HexabitzPlatform/H09R9x-Hardware/README.md

# H09R9x-Hardware
Hexabitz Thermopile Sensor Module Hardware Design
