HexabitzPlatform/H09R9x-Hardware/Rleased/BOM/H09R9.xlsx

 |  | www.hexabitz.com info@hexabitz.com |  | Bill Of Materials
Customer | Hexabitz | Revision | 1
Project | Hexabitz Modules | Date | 2024-02-12
Board | Thermopile Sensor Module (H09R9) | Notes
Designator | Description | Manufacturer Part Number | Manufacturer | Octopart Url | Quantity
R | Headers & Wire Housings Unshrouded 1 POS T/H | 5-146280-1 | TE Connectivity | https://octopart.com/5-146280-1-te+connectivity+%2F+amp-40259676?r=sp | 1
SWD | Conn Unshrouded Header HDR 3 POS 2.54mm Solder ST Top Entry Thru-Hole Carton | 5-146281-3 | TE Connectivity | https://octopart.com/5-146281-3-te+connectivity+%2F+amp-39745942?r=sp | 1
R3 | RES SMD 0.0OHM JUMPER 1/10W 0603 | RC0603JR-070RL | YAGEO [VR] | https://octopart.com/rc0603jr-070rl-yageo-1241539?r=sp | 1
R1 | Thick Film Resistors - SMD 0603 270 Ohm 5% Tol | ERJ-3GEYJ271V | Panasonic | https://octopart.com/erj-3geyj271v-panasonic-55560546?r=sp | 1
R2, R4, R5 | RES 10K Ohm 1% 0603 | RC0603FR-0710KL | Yageo | https://octopart.com/rc0603fr-0710kl-yageo-40025538?r=sp | 3
C1, C6, C7, C8, C10 | CAP CER 0.1UF 25V X7R 0603 | CGA3E2X8R1E104K080AE | TDK | https://octopart.com/cga3e2x8r1e104k080ae-tdk-68305753?r=sp (https://octopart.com/c0603c104k8ractu-kemet-145075?r=sp) | 5
C2 | CAP CER 1 UF 16V X7R 0805 | CC0805KKX7R7BB105 | YAGEO [VA] | https://octopart.com/cc0805kkx7r7bb105-yageo-8376555?r=sp | 1
C3, C4, C11 | CAP CER 4.7UF 16V X7R 0805 | C0805C475K4RACTU | KEMET [VA] | https://octopart.com/c0805c475k4ractu-kemet-22859922?r=sp (https://octopart.com/10tpu4r7msi-panasonic-29487748?r=sp) | 3
FB1 | Ind chip Bead Multi-Layer 30 ohms 25% 100MHZ Ferrite 1,5A 0603Punched paper T/R | MMZ1608Y300BTA00 | TDK | https://octopart.com/mmz1608y300bta00-tdk-7906990?r=sp | 1
D1 | Red 0603 130° Clear 54 mcd 2 V Surface Mount ChipLED | VLMS1300-GS08 | Vishay | https://octopart.com/vlms1300-gs08-vishay-21709201?r=sp | 1
U1 | MCU 32-Bit ARM Cortex-M0+ RISC 512kByte Flash 1.7V to 3.6V 48-Pin UFQFPN Tray | STM32G0B1CEU6N | STMicroelectronics | https://octopart.com/stm32g0b1ceu6n-stmicroelectronics-116364672?r=sp | 1
U2 | TSD305 Series 1.68 to 3.6 V 100 uA Through Hole Digital Temperature Sensor -TO-5 | TSD305-1C55 | TE Connectivity | https://octopart.com/g-tpmo-101-te+connectivity-76900424?r=sp | 1
X1 | 8,0000MHZ 33pF SMD MURATA Resonators | CSTNE8M00G550000R0 | Murata | https://octopart.com/cstne8m00g550000r0-murata-91406934?r=sp | 1
