HexabitzPlatform/H09R9x-Hardware/Documentation/H09R9 Schematics.pdf

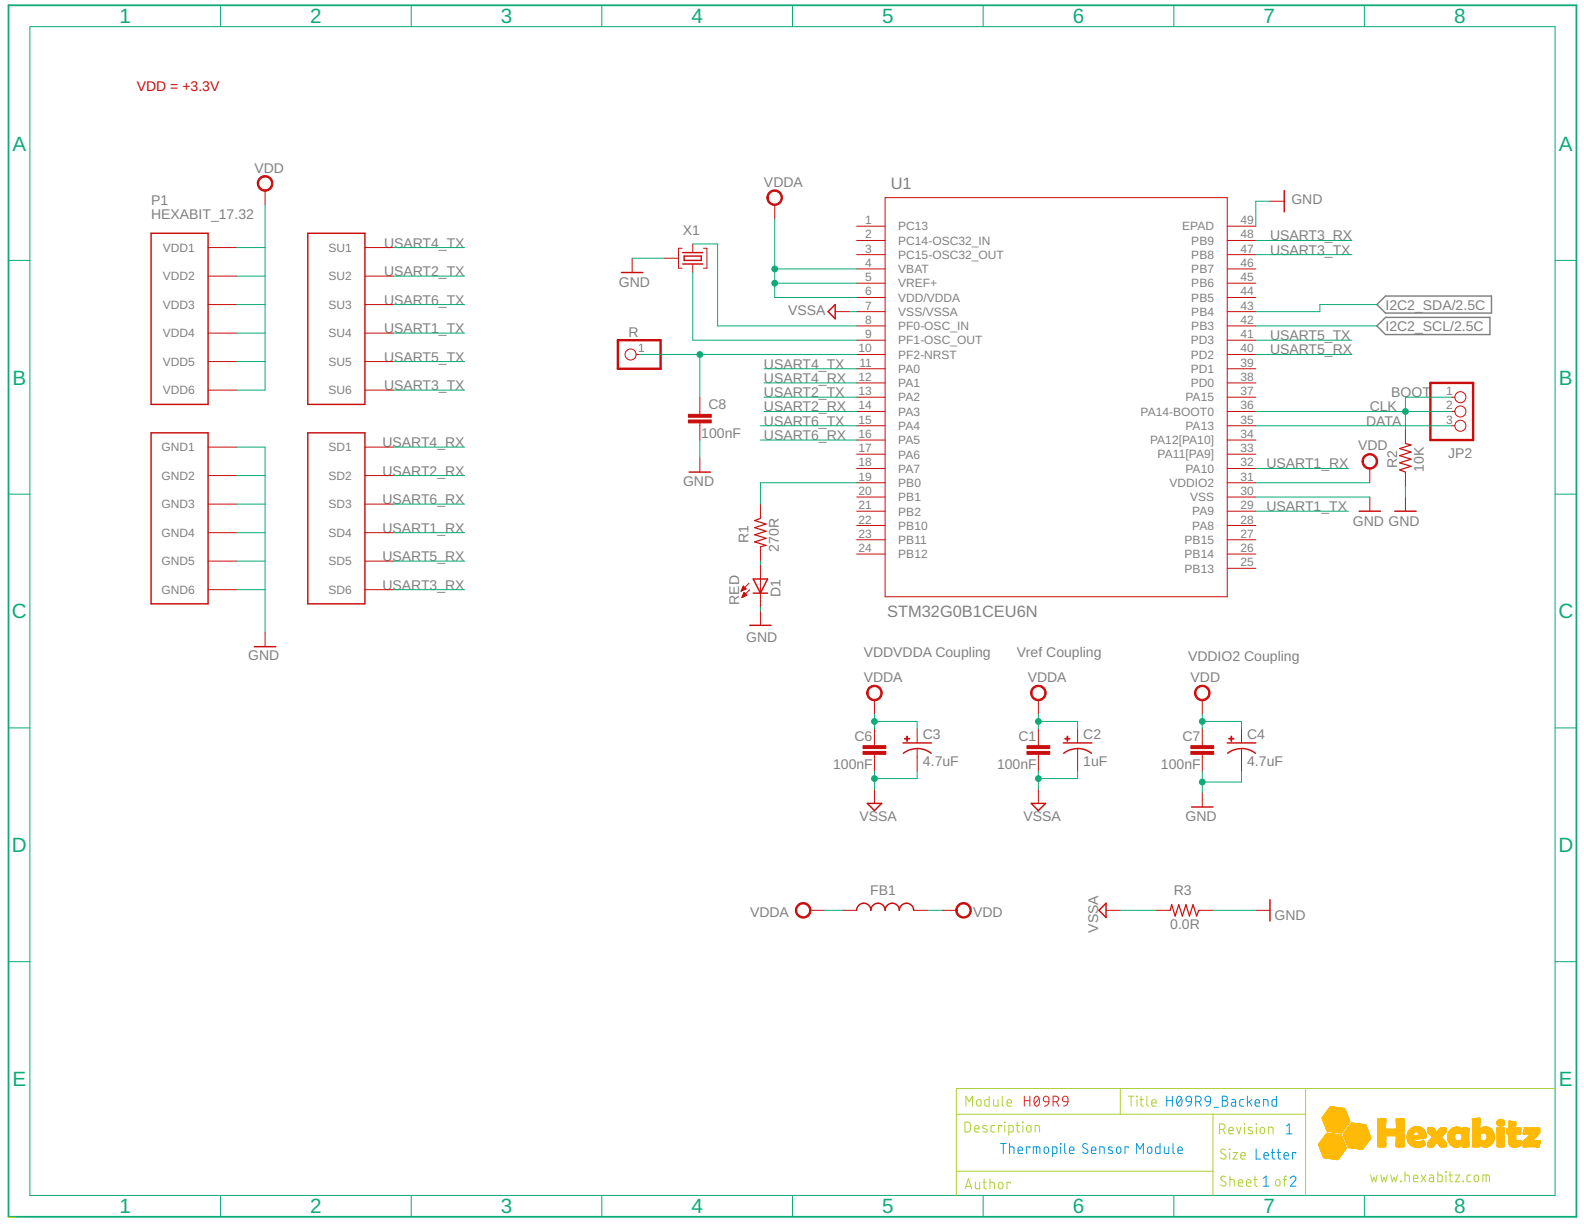
[picture p1: page 1]

5 | 45 PB7
6 | 44 PB6

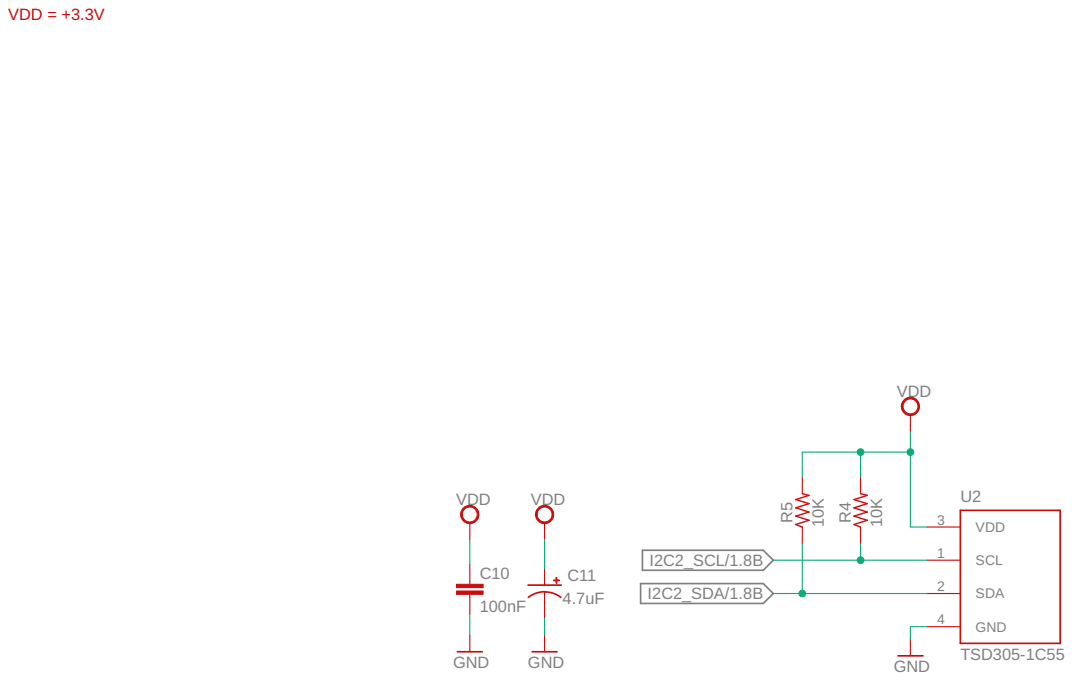
[picture p2: page 2]
