HexabitzPlatform/H09R9x-Hardware/Design/H09R9.brd

## EAGLE design Design/H09R9.brd (2024-02-13)

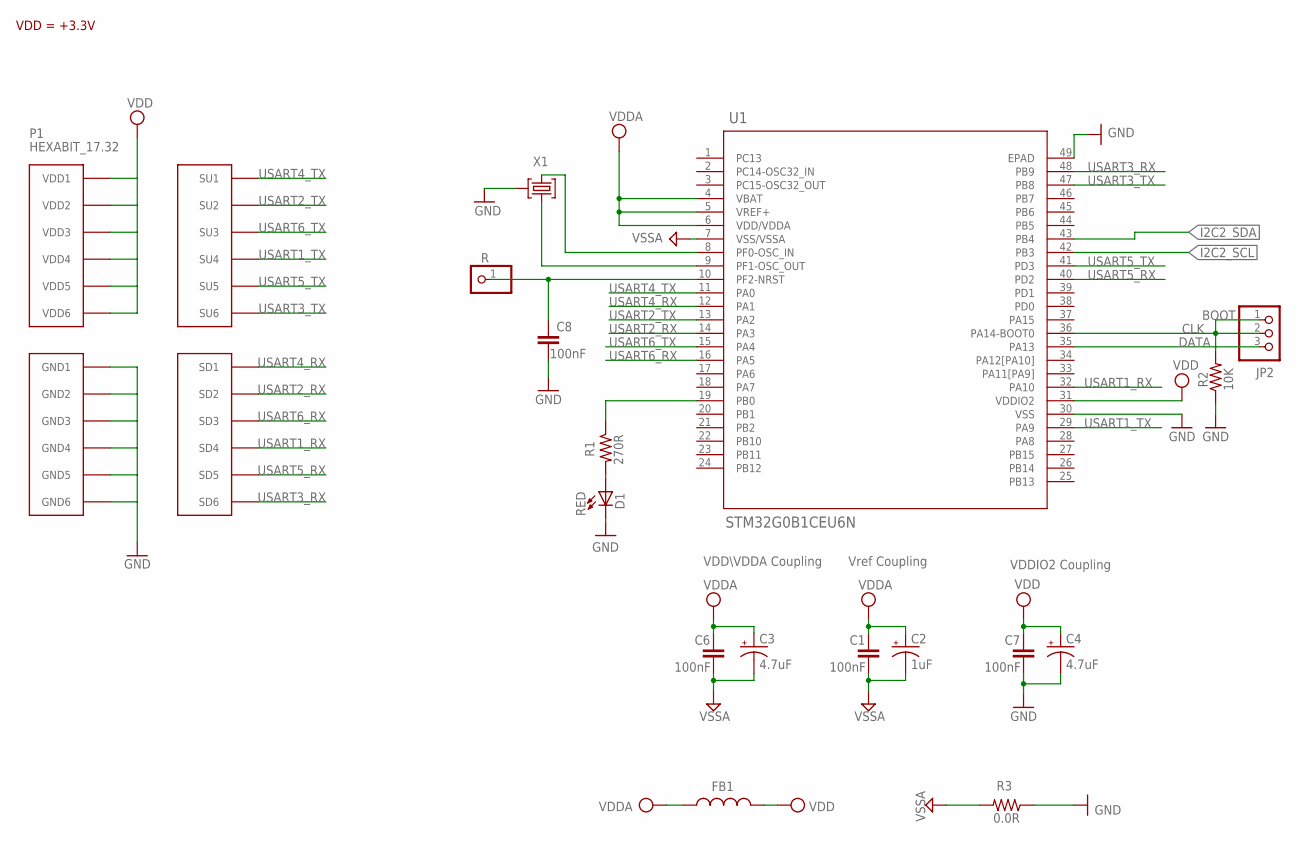
[picture p3: schematic H09R9.sch, sheet 1]

Parts:
C1, C6, C7, C8: 100nF; C-0603
C2: 1uF; C-0805-POL
C3, C4: 4.7uF; C-0805-POL
D1: RED; VLMS1300-GS08; MPN VLMS1300-GS08
FB1: FB-TDK_MMZ1608Y300B; MPN MMZ1608Y300B
JP2: PINHD-1X3; 1X03
P1: HEXABIT_17.32
R: R; 1X01
R1: 270R; R-0603
R2: 10K; R-0603
R3: 0.0R; R-0603; MPN RC0603JR-070RL
U1: STM32G0B1CEU6N; HEXABITZ_ICS_QFN_B1CEU6_STM-L
X1: XTALL_CSTCE8M00G52

Connections:
CLK: JP2.1, JP2.2, R2.2, U1.36 (PA14-BOOT0)
DATA: JP2.3, U1.35 (PA13)
GND: C4.2 (-), C7.2, C8.2, D1.C, P1.PAD_PD7 (GND1), P1.PAD_PD8 (GND2), P1.PAD_PD9 (GND3), P1.PAD_PD10 (GND4), P1.PAD_PD11 (GND5), P1.PAD_PD12 (GND6), R2.1, R3.1, U1.30 (VSS), U1.49 (EPAD), X1.P$2 (2); also elsewhere on the board
I2C2_SCL: U1.42 (PB3); also elsewhere on the board
I2C2_SDA: U1.43 (PB4); also elsewhere on the board
unnamed: R1.1, U1.19 (PB0)
unnamed: D1.A, R1.2
unnamed: C8.1, R.1, U1.10 (PF2-NRST)
unnamed: U1.9 (PF1-OSC_OUT), X1.P$1 (1)
unnamed: U1.8 (PF0-OSC_IN), X1.P$3 (3)
USART1_RX: P1.PAD_PD4 (SD4), U1.32 (PA10)
USART1_TX: P1.PAD_PU4 (SU4), U1.29 (PA9)
USART2_RX: P1.PAD_PD2 (SD2), U1.14 (PA3)
USART2_TX: P1.PAD_PU2 (SU2), U1.13 (PA2)
USART3_RX: P1.PAD_PD6 (SD6), U1.48 (PB9)
USART3_TX: P1.PAD_PU6 (SU6), U1.47 (PB8)
USART4_RX: P1.PAD_PD1 (SD1), U1.12 (PA1)
USART4_TX: P1.PAD_PU1 (SU1), U1.11 (PA0)
USART5_RX: P1.PAD_PD5 (SD5), U1.40 (PD2)
USART5_TX: P1.PAD_PU5 (SU5), U1.41 (PD3)
USART6_RX: P1.PAD_PD3 (SD3), U1.16 (PA5)
USART6_TX: P1.PAD_PU3 (SU3), U1.15 (PA4)
VDD: C4.1 (+), C7.1, FB1.2, P1.PAD_PU7 (VDD1), P1.PAD_PU8 (VDD2), P1.PAD_PU9 (VDD3), P1.PAD_PU10 (VDD4), P1.PAD_PU11 (VDD5), P1.PAD_PU12 (VDD6), U1.31 (VDDIO2); also elsewhere on the board
VDDA: C1.1, C2.1 (+), C3.1 (+), C6.1, FB1.1, U1.4 (VBAT), U1.5 (VREF+), U1.6 (VDD/VDDA)
VSSA: C1.2, C2.2 (-), C3.2 (-), C6.2, R3.2, U1.7 (VSS/VSSA)

Notes on the sheet:
VDD = +3.3V
Vref Coupling
VDDIO2 Coupling
VDD\VDDA Coupling
BOOT

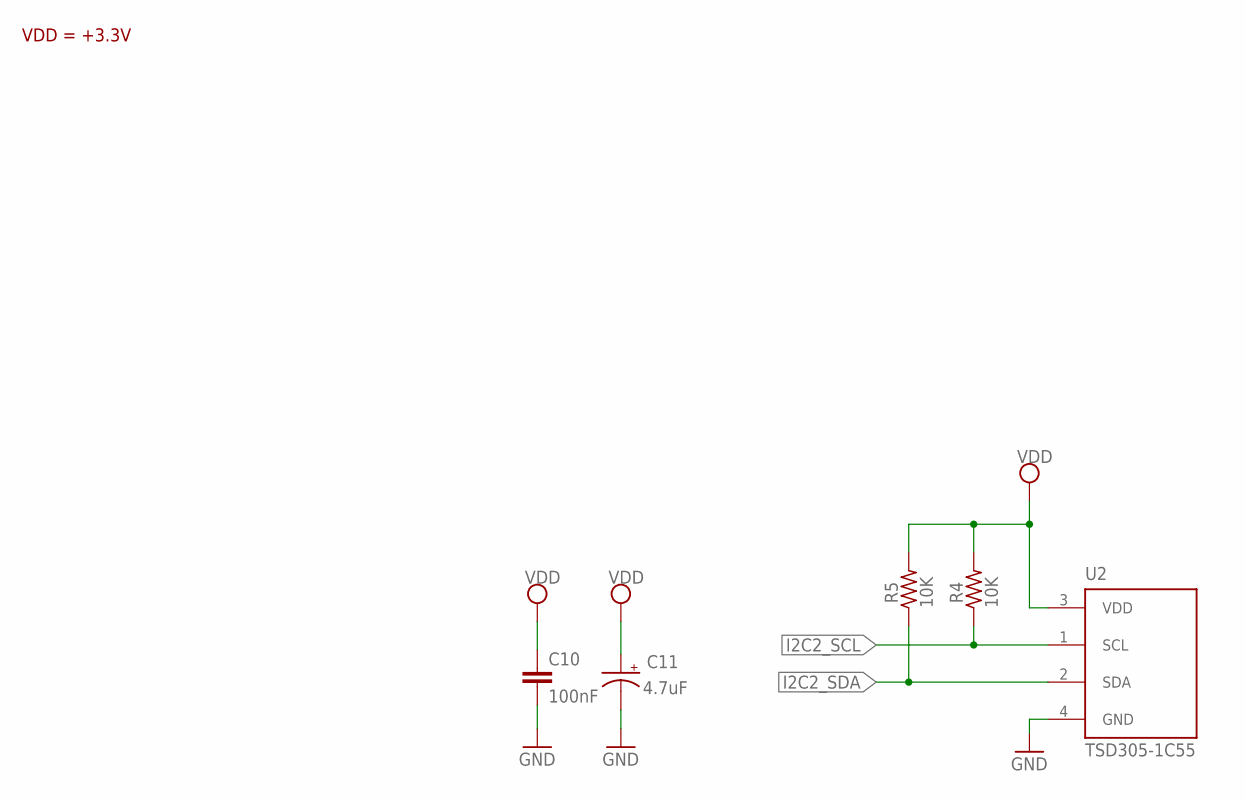
[picture p4: schematic H09R9.sch, sheet 2]

Parts:
C10: 100nF; C-0603; TOLERANCE 10%; VOLTAGE_RATING 16.0 V; MPN 0603YC104K4T2A
C11: 4.7uF; C-0805-POL; TOLERANCE 20%; VOLTAGE_RATING 10.0 V; MPN 10TPU4R7MSI
R4, R5: 10K; R-0603
U2: TSD305-1C55; TEMPERATURESENSOR-TO5

Connections:
GND: C10.2, C11.2 (-), U2.4 (GND); also elsewhere on the board
I2C2_SCL: R4.1, U2.1 (SCL); also elsewhere on the board
I2C2_SDA: R5.1, U2.2 (SDA); also elsewhere on the board
VDD: C10.1, C11.1 (+), R4.2, R5.2, U2.3 (VDD); also elsewhere on the board

Notes on the sheet:
VDD = +3.3V

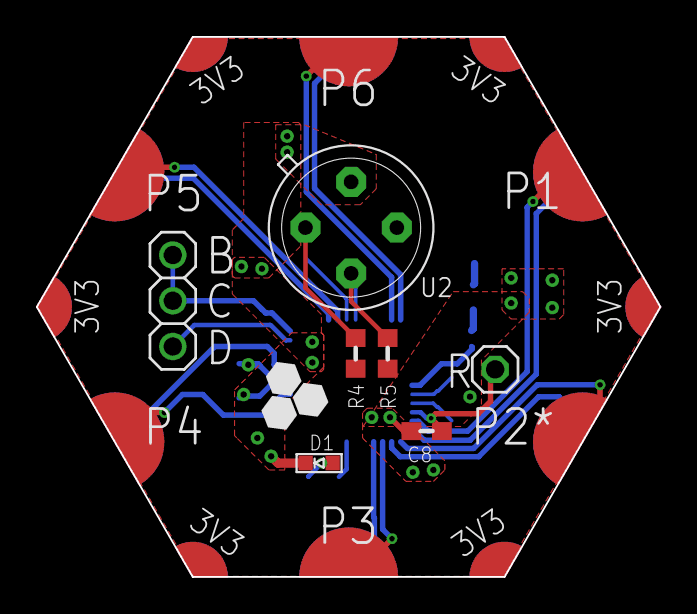
[picture p5: board H09R9.brd from above]

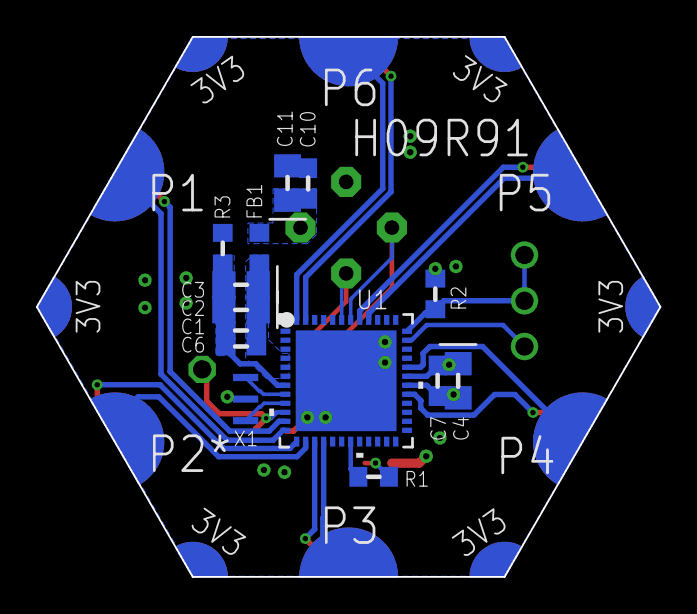
[picture p6: board H09R9.brd from below]

Board: 2 copper layers, 34.6 x 30.0 mm, 22 parts (14 on the bottom side), 25 nets.
