HexabitzPlatform/H09R9x-Hardware/(commit log)

2021-03-21 first schematic
    [H01R01.brd, H01R01.sch]
2021-03-21 first edit
    [H01R01.brd, H01R01.sch]
2021-03-21 not routing yet
    [H09R9x.brd, H09R9x.sch]
2021-03-28 first version sch brd .
    [H09R9x.brd, H09R9x.sch]
2021-03-31 brd edit
    [H09R9x.brd]
2021-04-16 edit brd
    [H09R9x.brd]
2021-04-20 data upload
    [BOM.xlsx, H09R9x.brd, H09R9x.sch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]
2021-04-20 bom edit
    [BOM.xlsx]
2021-04-20 edit documents
    [H09R9x.brd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]
2021-04-21 chage thermopile print to last version
    [H09R9x.brd, H09R9x.sch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]
2024-01-01 Creat H09R90 folder
    [BOM.xlsx, H09R9x.brd, H09R9x.sch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]
2024-01-02 -Standarize the files and folders
    [BOM.xlsx, H09R9.brd, H09R9.sch, H09R9.xlsx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]
2024-02-13 - The reviewed version is complete. - The upgraded version features the STM32G0B1CEU6N MCU. - Pull-up resistors have been added to the I2C Bus.
    [H09R9.brd, H09R9.sch, H09R9.xlsx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]
2024-05-18 Update the BOM
    [H09R9.xlsx]
